Ilvesmaki/C-DAO/README.md

# template_HW_SW_project_repository
This repository will have required folder structure for a project that have hardware, software and even CAD designs
