Ilvesmaki/C-DAO/CAD/CL13843G_body.SLDPRT

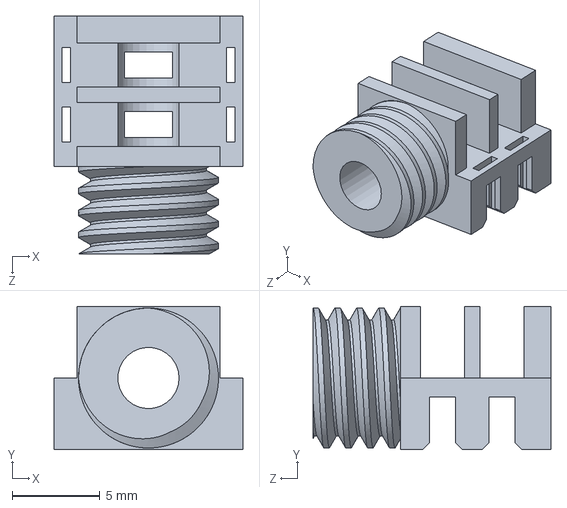
[picture p1: CAD file, 2022-03-21]
CAD/CL13843G_body.SLDPRT
10.8 x 8.20 x 13.6 mm
