Ilvesmaki/C-DAO/CAD/CL13843G.STEP

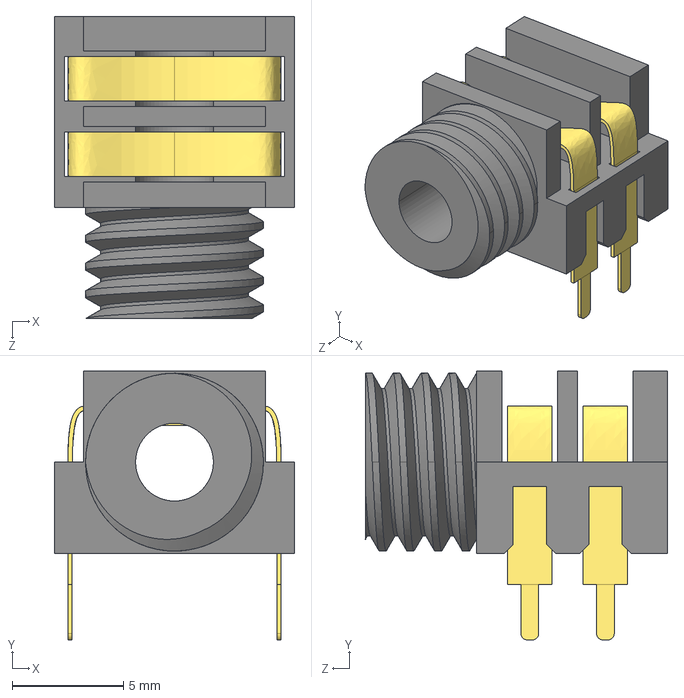
[picture p2: CAD file, 2022-03-21]
CAD/CL13843G.STEP
10.8 x 12.1 x 13.6 mm
CL13843G_body
CL13843G_PINS x 2
