Ilvesmaki/C-DAO/CAD/CL13843G_PINS.SLDPRT

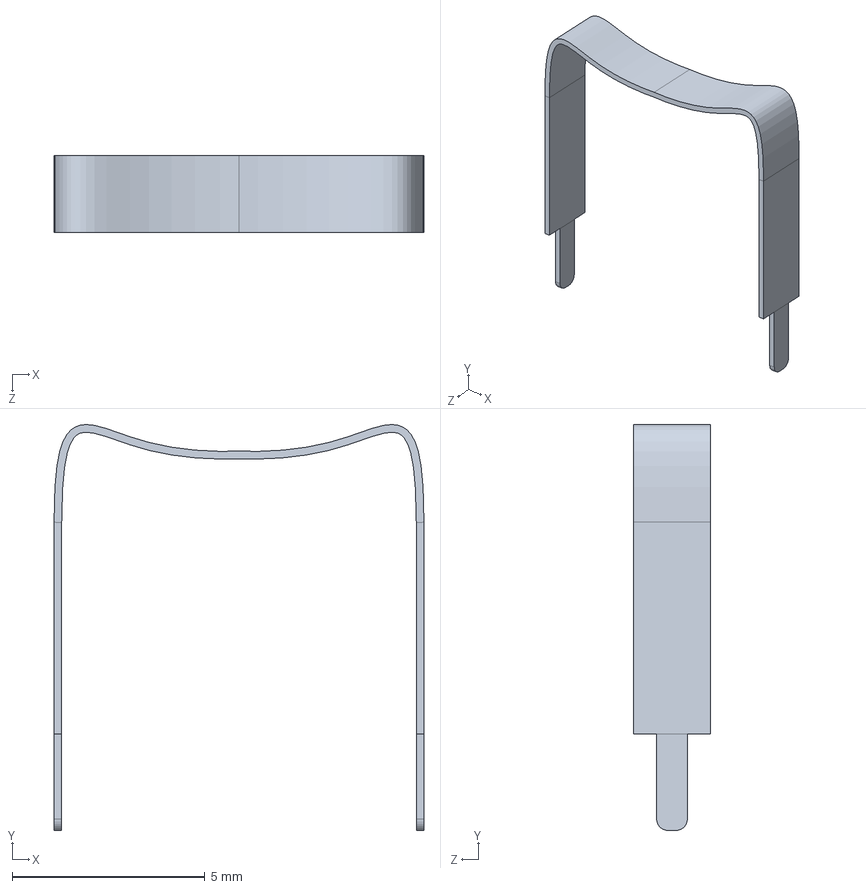
[picture p3: CAD file, 2022-03-21]
CAD/CL13843G_PINS.SLDPRT
9.60 x 10.5 x 2.00 mm
