Ilvesmaki/C-DAO/(list of files, cad)

Other CAD files:
CAD/Board.FCStd
CAD/CL13843G.SLDASM
