Ilvesmaki/C-DAO/Hardware/C-DAO/C-DAO.kicad_pcb

## KiCad design Hardware/C-DAO/C-DAO.kicad_pcb (2022-03-21)

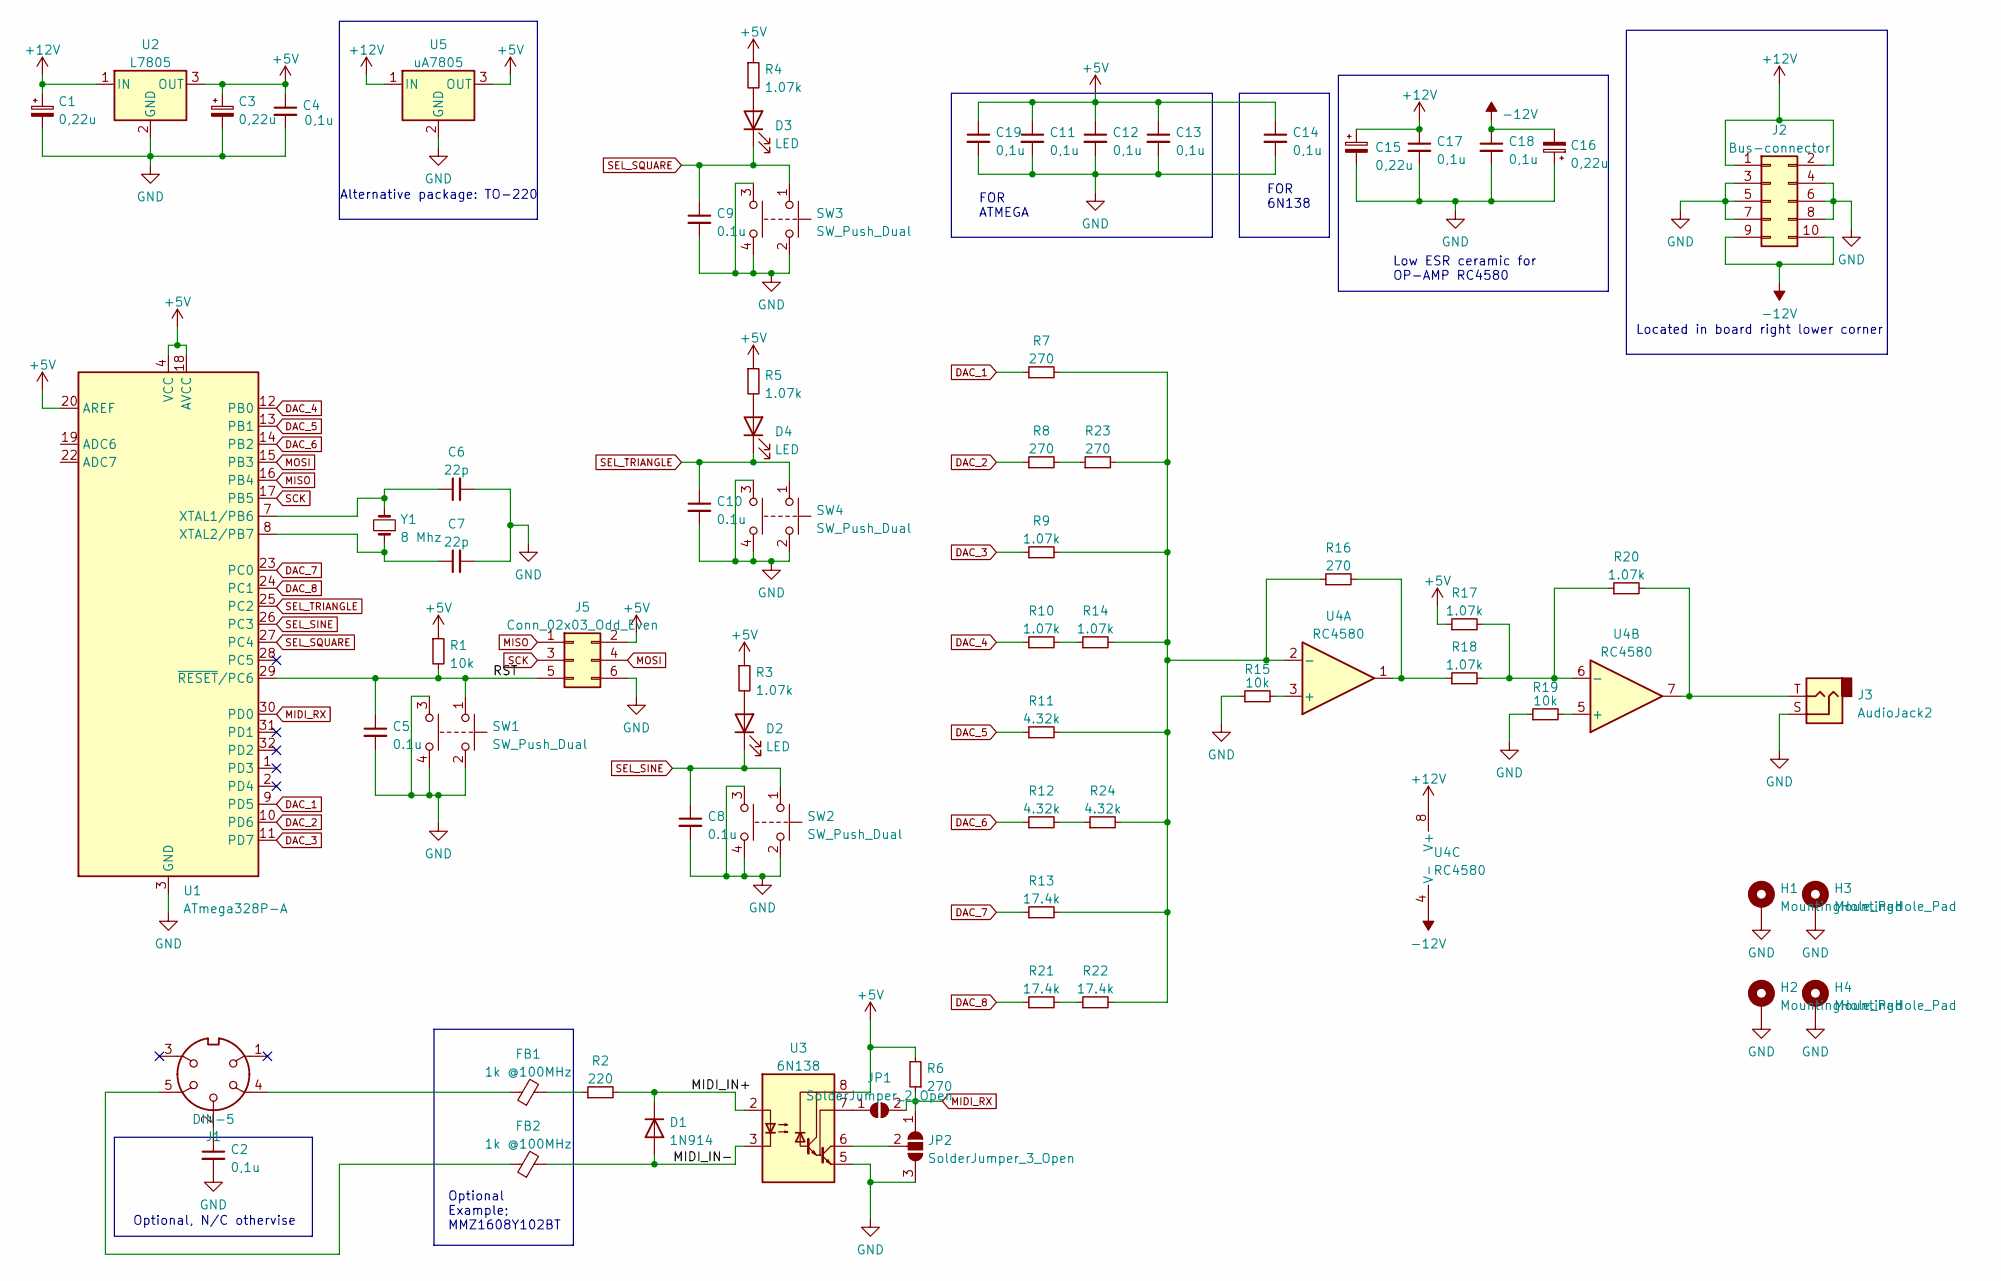
[picture p4: schematic C-DAO.kicad_sch]

Parts:
C1, C3, C15, C16: 0,22u; CP_Elec_4x5.4
C2, C4, C11, C12, C13, C14, C17, C18, C19: 0,1u; C_0603_1608Metric_Pad1.08x0.95mm_HandSolder
C5, C8, C9, C10: 0.1u; C_0603_1608Metric_Pad1.08x0.95mm_HandSolder
C6, C7: 22p; C_0603_1608Metric_Pad1.08x0.95mm_HandSolder
D1: 1N914; D_DO-35_SOD27_P7.62mm_Horizontal
D2, D3, D4: LED; LED_D5.0mm_Horizontal_O6.35mm_Z15.0mm
FB1, FB2: 1k @100MHz; L_0603_1608Metric_Pad1.05x0.95mm_HandSolder
H1, H2, H3, H4: MountingHole_Pad; MountingHole_3.2mm_M3_DIN965_Pad_TopBottom
J1: DIN-5; 5-pin DIN socket vertical
J2: Bus-connector; PinHeader_2x05_P2.54mm_Vertical
J3: AudioJack2; Cliff CL13843G 3.5mm mono jack
J5: Conn_02x03_Odd_Even; PinHeader_2x03_P2.54mm_Horizontal
JP1: SolderJumper_2_Open; SolderJumper-2_P1.3mm_Open_Pad1.0x1.5mm
JP2: SolderJumper_3_Open; SolderJumper-3_P1.3mm_Open_Pad1.0x1.5mm_NumberLabels
R1, R15, R19: 10k; R_0603_1608Metric_Pad0.98x0.95mm_HandSolder
R2: 220; R_0603_1608Metric_Pad0.98x0.95mm_HandSolder
R3, R4, R5, R9, R10, R14, R17, R18, R20: 1.07k; R_0603_1608Metric_Pad0.98x0.95mm_HandSolder
R6, R7, R8, R16, R23: 270; R_0603_1608Metric_Pad0.98x0.95mm_HandSolder
R11, R12, R24: 4.32k; R_0603_1608Metric_Pad0.98x0.95mm_HandSolder
R13, R21, R22: 17.4k; R_0603_1608Metric_Pad0.98x0.95mm_HandSolder
SW1, SW2, SW3, SW4: SW_Push_Dual; 1825968-2
U1: ATmega328P-A; TQFP-32_7x7mm_P0.8mm
U2: L7805; SOT-223-3_TabPin2
U3: 6N138; DIP-8_W7.62mm_LongPads
U4: RC4580; SOIC-8_3.9x4.9mm_P1.27mm
U5: uA7805; TO-220-3_Vertical
Y1: 8 Mhz; Crystal_SMD_HC49-SD

Connections:
+5V: C3.1, C4.1, C11.1, C12.1, C13.1, C14.1, C19.1, J5.2, R1.1, R3.1, R4.1, R5.1, R6.2, R17.1, U1.4 (VCC), U1.6 (VCC), U1.18 (AVCC), U1.20 (AREF), U2.3 (OUT), U3.8 (VCC), U5.3 (OUT)
+12V: C1.1, C15.1, C17.1, J2.1, J2.2, U2.1 (IN), U4.8 (V+), U5.1 (IN)
-12V: C16.2, C18.1, J2.9, J2.10, U4.4 (V-)
/MIDI_IN+: D1.1 (K), R2.2, U3.2 (C1)
/MIDI_IN-: D1.2 (A), FB2.2, U3.3 (C2)
/RST: C5.1, J5.5, R1.2, SW1.1, U1.29 (~RESET/PC6)
DAC_1: R7.1, U1.9 (PD5)
DAC_2: R8.1, U1.10 (PD6)
DAC_3: R9.1, U1.11 (PD7)
DAC_4: R10.1, U1.12 (PB0)
DAC_5: R11.1, U1.13 (PB1)
DAC_6: R12.1, U1.14 (PB2)
DAC_7: R13.1, U1.23 (PC0)
DAC_8: R21.1, U1.24 (PC1)
GND: C1.2, C2.2, C3.2, C4.2, C5.2, C6.2, C7.2, C8.2, C9.2, C10.2, C11.2, C12.2, C13.2, C14.2, C15.2, C16.1, C17.2, C18.2, C19.2, H1.1, H2.1, H3.1, H4.1, J2.3, J2.4, J2.5, J2.6, J2.7, J2.8, J3.S, J5.6, JP2.3 (B), R15.1, R19.1, SW1.2, SW1.3, SW1.4, SW2.2, SW2.3, SW2.4, SW3.2, SW3.3, SW3.4, SW4.2, SW4.3, SW4.4, U1.3 (GND), U1.5 (GND), U1.21 (GND), U2.2 (GND), U3.5 (GND), U5.2 (GND)
MIDI_RX: JP1.2 (B), JP2.1 (A), R6.1, U1.30 (PD0)
MISO: J5.1, U1.16 (PB4)
MOSI: J5.4, U1.15 (PB3)
unnamed: C2.1, J1.2
unnamed: C6.1, U1.7 (XTAL1/PB6), Y1.2
unnamed: C7.1, U1.8 (XTAL2/PB7), Y1.1
unnamed: D2.2 (A), R3.2
unnamed: D3.2 (A), R4.2
unnamed: D4.2 (A), R5.2
unnamed: FB1.1, J1.4
unnamed: FB1.2, R2.1
unnamed: FB2.1, J1.5
unnamed: J3.T, R20.2, U4.7
unnamed: JP1.1 (A), U3.7 (VO1)
unnamed: JP2.2 (C), U3.6 (VO2)
unnamed: R10.2, R14.1
unnamed: R7.2, R9.2, R11.2, R13.2, R14.2, R16.1, R22.2, R23.2, R24.2, U4.2 (-)
unnamed: R12.2, R24.1
unnamed: R15.2, U4.3 (+)
unnamed: R16.2, R18.1, U4.1
unnamed: R17.2, R18.2, R20.1, U4.6 (-)
unnamed: R19.2, U4.5 (+)
unnamed: R21.2, R22.1
unnamed: R8.2, R23.1
SCK: J5.3, U1.17 (PB5)
SEL_SINE: C8.1, D2.1 (K), SW2.1, U1.26 (PC3)
SEL_SQUARE: C9.1, D3.1 (K), SW3.1, U1.27 (PC4)
SEL_TRIANGLE: C10.1, D4.1 (K), SW4.1, U1.25 (PC2)

Notes on the sheet:
FOR ATMEGA
Optional, N/C othervise
Located in board right lower corner
Optional Example; MMZ1608Y102BT
Low ESR ceramic for OP-AMP RC4580
FOR 6N138
Alternative package: TO-220

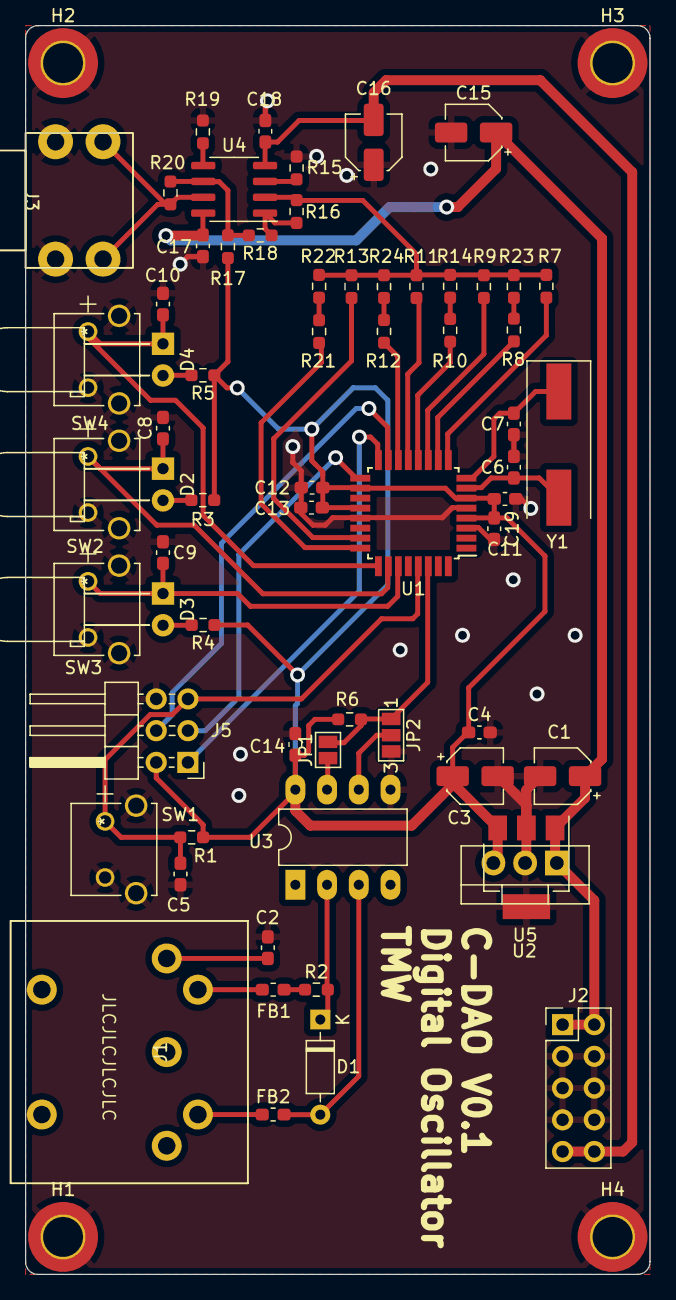
[picture p5: board C-DAO.kicad_pcb from above]

Board: 2 copper layers, 50.0 x 100.0 mm, 69 parts (0 on the bottom side), 43 nets.
