Ilvesmaki/C-DAO/Firmware/C-DAO/include/waveforms.h

/**
 * @file waveforms.h
 * @author your name (you@domain.com)
 * @brief 
 * @version 0.1
 * @date 2022-04-07
 * 
 * @copyright Copyright (c) 2022
 * 
 */

#ifndef WAVEFORMS_H
#define WAVEFORMS_H

#include "stdint.h"

#define WAVEFORM_SINE 0
#define WAVEFORM_SQUARE 1
#define WAVEFORM_TRIANGLE 2

#define WAVEFORM_COUNT 3
#define WAVEFORM_LUT_SIZE 256

const uint8_t WAVEFORMS[WAVEFORM_COUNT][WAVEFORM_LUT_SIZE] = {
    { // Sine wave, one cycle
    0x80, 0x83, 0x86, 0x89, 0x8C, 0x90, 0x93, 0x96,
    0x99, 0x9C, 0x9F, 0xA2, 0xA5, 0xA8, 0xAB, 0xAE,
    0xB1, 0xB3, 0xB6, 0xB9, 0xBC, 0xBF, 0xC1, 0xC4,
    0xC7, 0xC9, 0xCC, 0xCE, 0xD1, 0xD3, 0xD5, 0xD8,
    0xDA, 0xDC, 0xDE, 0xE0, 0xE2, 0xE4, 0xE6, 0xE8,
    0xEA, 0xEB, 0xED, 0xEF, 0xF0, 0xF1, 0xF3, 0xF4,
    0xF5, 0xF6, 0xF8, 0xF9, 0xFA, 0xFA, 0xFB, 0xFC,
    0xFD, 0xFD, 0xFE, 0xFE, 0xFE, 0xFF, 0xFF, 0xFF,
    0xFF, 0xFF, 0xFF, 0xFF, 0xFE, 0xFE, 0xFE, 0xFD,
    0xFD, 0xFC, 0xFB, 0xFA, 0xFA, 0xF9, 0xF8, 0xF6,
    0xF5, 0xF4, 0xF3, 0xF1, 0xF0, 0xEF, 0xED, 0xEB,
    0xEA, 0xE8, 0xE6, 0xE4, 0xE2, 0xE0, 0xDE, 0xDC,
    0xDA, 0xD8, 0xD5, 0xD3, 0xD1, 0xCE, 0xCC, 0xC9,
    0xC7, 0xC4, 0xC1, 0xBF, 0xBC, 0xB9, 0xB6, 0xB3,
    0xB1, 0xAE, 0xAB, 0xA8, 0xA5, 0xA2, 0x9F, 0x9C,
    0x99, 0x96, 0x93, 0x90, 0x8C, 0x89, 0x86, 0x83,
    0x80, 0x7D, 0x7A, 0x77, 0x74, 0x70, 0x6D, 0x6A,
    0x67, 0x64, 0x61, 0x5E, 0x5B, 0x58, 0x55, 0x52,
    0x4F, 0x4D, 0x4A, 0x47, 0x44, 0x41, 0x3F, 0x3C,
    0x39, 0x37, 0x34, 0x32, 0x2F, 0x2D, 0x2B, 0x28,
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
    0x4e, 0x4c, 0x4a, 0x48, 0x46, 0x44, 0x42, 0x40,
    0x3e, 0x3c, 0x3a, 0x38, 0x36, 0x34, 0x32, 0x30,
    0x2e, 0x2c, 0x2a, 0x28, 0x26, 0x24, 0x22, 0x20,
    0x1e, 0x1c, 0x1a, 0x18, 0x16, 0x14, 0x12, 0x10,
    0x0e, 0x0c, 0x0a, 0x08, 0x06, 0x04, 0x02, 0x00,
    }
};

#endif // WAVEFORMS_H
