Ilvesmaki/C-DAO/Firmware/C-DAO/include/timer.h

/**
 * @file frequency.h
 * @author your name (you@domain.com)
 * @brief 
 * @version 0.1
 * @date 2022-04-07
 * 
 * @copyright Copyright (c) 2022
 * 
 */

#ifndef TIMER_H
#define TIMER_H

#include "stdint.h"

typedef void (*callback_f)();

class Timer
{
public:
    Timer();
    ~Timer();

    void SetEnable(bool set);
    void SetFrequency(uint32_t freq);
    void SetCallback(callback_f callback);
};

#endif // TIMER_H
