Ilvesmaki/C-DAO/(commit log)

2022-02-28 Schematics and PCB V0.1 done
    [ATMEGA328P-PINS.xlsx, C-DAO.kicad_pcb, C-DAO.kicad_sch]
2022-03-15 Add production files and latest pcb files with bom
    [ATMEGA328.xlsx, ATMEGA328P-PINS.xlsx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]
2022-03-21 Update 3d models and create wrl-model from board
    [Board.FCStd, C-DAO.kicad_pcb, C-DAO.kicad_sch, CL13843G.SLDASM, CL13843G.STEP, CL13843G_PINS.SLDPRT, CL13843G_body.SLDPRT]
2022-04-08 Rename frequency module to timer
